aynurin/nourik/README.md

# NourK

ToDo:

 - [ ] Find a chip.
 - [#1](/../../issues/1) Create a layout
 - [#2](/../../issues/2) Find an existing PCB
