aynurin/nourik/pcb/core/Nour-Core.kicad_pcb

## KiCad design pcb/core/Nour-Core.kicad_pcb (2022-09-10)

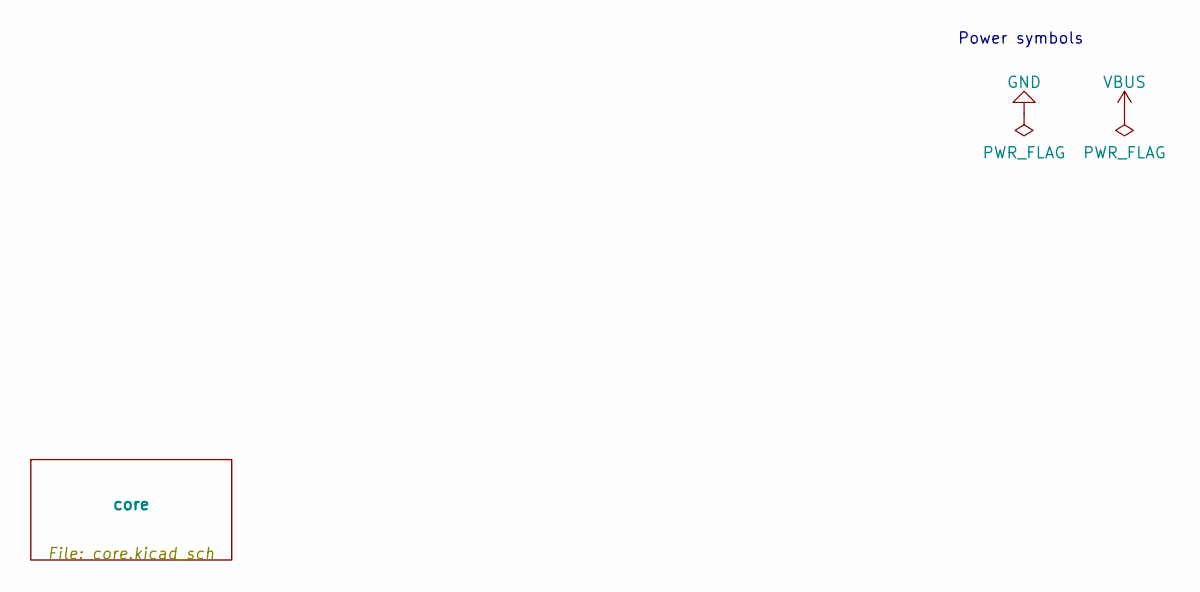
[picture p3: schematic Nour-Core.kicad_sch]

Notes on the sheet:
Power symbols

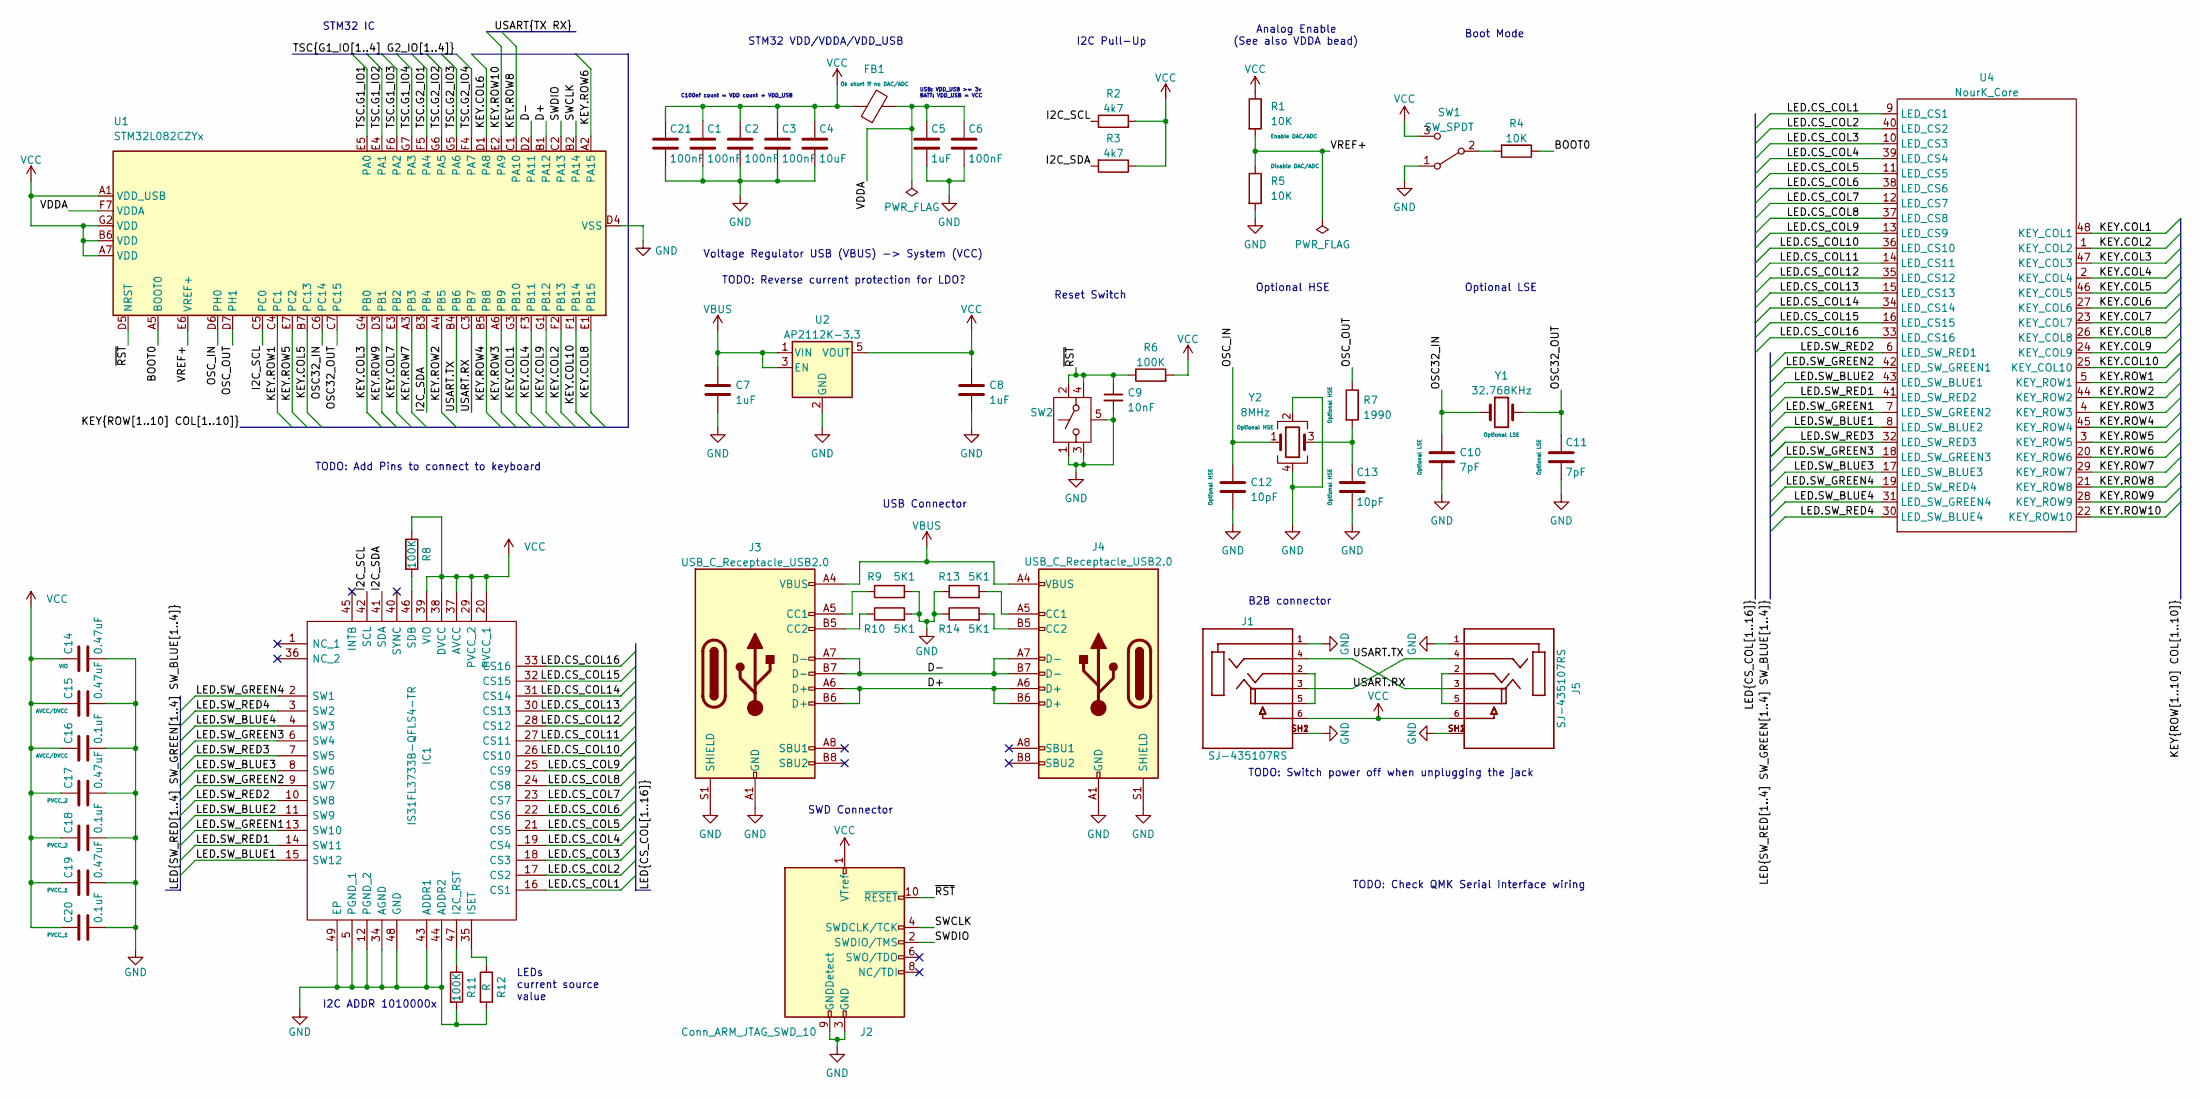
[picture p4: schematic core.kicad_sch]

Parts:
C1, C2, C3, C6, C21: 100nF; C_0805_2012Metric
C4: 10uF; C_0805_2012Metric
C5, C7, C8: 1uF; C_0805_2012Metric
C9: 10nF; C_0805_2012Metric
C10, C11: 7pF; C_0805_2012Metric
C12, C13: 10pF; C_0805_2012Metric
C14, C15, C17, C19: 0.47uF; C_0805_2012Metric
C16, C18, C20: 0.1uF; C_0805_2012Metric
FB1: FerriteBead; R_0805_2012Metric
IC1: IS31FL3733B-QFLS4-TR; QFN40P600X600X80-49N-D; Manufacturer_Part_Number IS31FL3733B-QFLS4-TR; Mouser Part Number 870-IS31FL3733BQFLS4
J1, J5: SJ-435107RS; CUI_SJ-435107RS
J2: Conn_ARM_JTAG_SWD_10; PinSocket_2x05_P1.27mm_Vertical
J3, J4: USB_C_Receptacle_USB2.0; GCT_USB4085-GF-A_REVA4
R1, R4, R5: 10K; R_0805_2012Metric
R2, R3: 4k7; R_0805_2012Metric
R6, R8, R11: 100K; R_0805_2012Metric
R7: 1990; R_0805_2012Metric
R9, R10, R13, R14: 5K1; R_0805_2012Metric
R12: R; R_0805_2012Metric
SW1: SW_SPDT; CSS-1211TB
SW2: SW_SPST_G; EVQP9102W; PartNo EVQ-P9102W
U1: STM32L082CZYx; ST_WLCSP-49_Die447
U2: AP2112K-3.3; SOT-23-5
U4: NourK_Core; Nour_Core
Y1: 32.768KHz; ECS327712TR; PartNo ECS-.327-7-12-TR
Y2: 8MHz; ECS801830BAGNTR; PartNo ECS-80-10-30B-CWN-TR

Connections:
/core/BOOT0: R4.1, U1.A5 (BOOT0)
/core/D+: J3.A6 (D+), J3.B6 (D+), J4.A6 (D+), J4.B6 (D+), U1.B1 (PA12)
/core/D-: J3.A7 (D-), J3.B7 (D-), J4.A7 (D-), J4.B7 (D-), U1.D2 (PA11)
/core/I2C_SCL: IC1.42 (SCL), R2.1, U1.C5 (PC0)
/core/I2C_SDA: IC1.41 (SDA), R3.2, U1.B3 (PB4)
/core/KEY.COL1: U1.G3 (PB10), U4.48 (KEY_COL1)
/core/KEY.COL2: U1.F2 (PB13), U4.1 (KEY_COL2)
/core/KEY.COL3: U1.G4 (PB0), U4.47 (KEY_COL3)
/core/KEY.COL4: U1.F3 (PB11), U4.2 (KEY_COL4)
/core/KEY.COL5: U1.B7 (PC13), U4.46 (KEY_COL5)
/core/KEY.COL6: U1.D1 (PA8), U4.27 (KEY_COL6)
/core/KEY.COL7: U1.E3 (PB2), U4.23 (KEY_COL7)
/core/KEY.COL8: U1.E1 (PB15), U4.26 (KEY_COL8)
/core/KEY.COL9: U1.G1 (PB12), U4.24 (KEY_COL9)
/core/KEY.COL10: U1.F1 (PB14), U4.25 (KEY_COL10)
/core/KEY.ROW1: U1.C4 (PC1), U4.5 (KEY_ROW1)
/core/KEY.ROW2: U1.A4 (PB5), U4.44 (KEY_ROW2)
/core/KEY.ROW3: U1.A6 (PB9), U4.4 (KEY_ROW3)
/core/KEY.ROW4: U1.B5 (PB8), U4.45 (KEY_ROW4)
/core/KEY.ROW5: U1.E7 (PC2), U4.3 (KEY_ROW5)
/core/KEY.ROW6: U1.A2 (PA15), U4.20 (KEY_ROW6)
/core/KEY.ROW7: U1.A3 (PB3), U4.29 (KEY_ROW7)
/core/KEY.ROW8: U1.C1 (PA10), U4.21 (KEY_ROW8)
/core/KEY.ROW9: U1.D3 (PB1), U4.28 (KEY_ROW9)
/core/KEY.ROW10: U1.E2 (PA9), U4.22 (KEY_ROW10)
/core/LED.CS_COL1: IC1.16 (CS1), U4.9 (LED_CS1)
/core/LED.CS_COL2: IC1.17 (CS2), U4.40 (LED_CS2)
/core/LED.CS_COL3: IC1.18 (CS3), U4.10 (LED_CS3)
/core/LED.CS_COL4: IC1.19 (CS4), U4.39 (LED_CS4)
/core/LED.CS_COL5: IC1.21 (CS5), U4.11 (LED_CS5)
/core/LED.CS_COL6: IC1.22 (CS6), U4.38 (LED_CS6)
/core/LED.CS_COL7: IC1.23 (CS7), U4.12 (LED_CS7)
/core/LED.CS_COL8: IC1.24 (CS8), U4.37 (LED_CS8)
/core/LED.CS_COL9: IC1.25 (CS9), U4.13 (LED_CS9)
/core/LED.CS_COL10: IC1.26 (CS10), U4.36 (LED_CS10)
/core/LED.CS_COL11: IC1.27 (CS11), U4.14 (LED_CS11)
/core/LED.CS_COL12: IC1.28 (CS12), U4.35 (LED_CS12)
/core/LED.CS_COL13: IC1.30 (CS13), U4.15 (LED_CS13)
/core/LED.CS_COL14: IC1.31 (CS14), U4.34 (LED_CS14)
/core/LED.CS_COL15: IC1.32 (CS15), U4.16 (LED_CS15)
/core/LED.CS_COL16: IC1.33 (CS16), U4.33 (LED_CS16)
/core/LED.SW_BLUE1: IC1.15 (SW12), U4.8 (LED_SW_BLUE2)
/core/LED.SW_BLUE2: IC1.11 (SW9), U4.43 (LED_SW_BLUE1)
/core/LED.SW_BLUE3: IC1.8 (SW6), U4.17 (LED_SW_BLUE3)
/core/LED.SW_BLUE4: IC1.4 (SW3), U4.31 (LED_SW_GREEN4)
/core/LED.SW_GREEN1: IC1.13 (SW10), U4.7 (LED_SW_GREEN2)
/core/LED.SW_GREEN2: IC1.9 (SW7), U4.42 (LED_SW_GREEN1)
/core/LED.SW_GREEN3: IC1.6 (SW4), U4.18 (LED_SW_GREEN3)
/core/LED.SW_GREEN4: IC1.2 (SW1), U4.19 (LED_SW_RED4)
/core/LED.SW_RED1: IC1.14 (SW11), U4.41 (LED_SW_RED2)
/core/LED.SW_RED2: IC1.10 (SW8), U4.6 (LED_SW_RED1)
/core/LED.SW_RED3: IC1.7 (SW5), U4.32 (LED_SW_RED3)
/core/LED.SW_RED4: IC1.3 (SW2), U4.30 (LED_SW_BLUE4)
/core/OSC32_IN: C10.1, U1.C6 (PC14), Y1.1
/core/OSC32_OUT: C11.1, U1.C7 (PC15), Y1.2
/core/OSC_IN: C12.1, U1.D6 (PH0), Y2.1
/core/OSC_OUT: R7.1, U1.D7 (PH1)
/core/SWCLK: J2.4 (SWDCLK/TCK), U1.B2 (PA14)
/core/SWDIO: J2.2 (SWDIO/TMS), U1.C2 (PA13)
/core/TSC.G1_IO1: U1.E5 (PA0)
/core/TSC.G1_IO2: U1.E4 (PA1)
/core/TSC.G1_IO3: U1.F6 (PA2)
/core/TSC.G1_IO4: U1.G7 (PA3)
/core/TSC.G2_IO1: U1.F5 (PA4)
/core/TSC.G2_IO2: U1.G6 (PA5)
/core/TSC.G2_IO3: U1.G5 (PA6)
/core/TSC.G2_IO4: U1.F4 (PA7)
/core/USART.RX: J1.3, J5.4, U1.C3 (PB7)
/core/USART.TX: J1.4, J5.3, U1.B4 (PB6)
/core/VDDA: C5.1, C6.1, FB1.2, U1.F7 (VDDA)
/core/VREF+: R1.2, R5.1, U1.E6 (VREF+)
/core/~RST: C9.1, J2.10 (~RESET), R6.1, SW2.2 (B), SW2.4 (B), U1.D5 (NRST)
GND: C1.2, C2.2, C3.2, C4.2, C5.2, C6.2, C7.2, C8.2, C9.2, C10.2, C11.2, C12.2, C13.2, C14.2, C15.2, C16.2, C17.2, C18.2, C19.2, C20.2, C21.2, IC1.5 (PGND_1), IC1.12 (PGND_2), IC1.34 (AGND), IC1.43 (ADDR1), IC1.44 (ADDR2), IC1.48 (GND), IC1.49 (EP), J1.1, J1.SH1, J1.SH2, J2.3 (GND), J2.5 (GND), J2.9 (GNDDetect), J3.A1 (GND), J3.A12 (GND), J3.B1 (GND), J3.B12 (GND), J3.S1 (SHIELD), J4.A1 (GND), J4.A12 (GND), J4.B1 (GND), J4.B12 (GND), J4.S1 (SHIELD), J5.1, J5.SH1, J5.SH2, R5.2, R9.2, R10.2, R11.2, R12.2, R13.1, R14.1, SW1.1 (A), SW2.1 (A), SW2.3 (A), SW2.5 (G), U1.D4 (VSS), U2.2 (GND), Y2.2, Y2.4
unnamed: C13.1, R7.2, Y2.3
unnamed: IC1.35 (ISET), R12.1
unnamed: IC1.46 (SDB), R8.2
unnamed: IC1.47 (I2C_RST), R11.1
unnamed: J1.2, J1.5
unnamed: J3.A5 (CC1), R9.1
unnamed: J3.B5 (CC2), R10.1
unnamed: J4.A5 (CC1), R13.2
unnamed: J4.B5 (CC2), R14.2
unnamed: J5.2, J5.5
unnamed: R4.2, SW1.2 (B)
VBUS: C7.1, J3.A4 (VBUS), J3.A9 (VBUS), J3.B4 (VBUS), J3.B9 (VBUS), J4.A4 (VBUS), J4.A9 (VBUS), J4.B4 (VBUS), J4.B9 (VBUS), U2.1 (VIN), U2.3 (EN)
VCC: C1.1, C2.1, C3.1, C4.1, C8.1, C14.1, C15.1, C16.1, C17.1, C18.1, C19.1, C20.1, C21.1, FB1.1, IC1.20 (PVCC_1), IC1.29 (PVCC_2), IC1.37 (AVCC), IC1.38 (DVCC), IC1.39 (VIO), J1.6, J2.1 (VTref), J5.6, R1.1, R2.2, R3.1, R6.2, R8.1, SW1.3 (C), U1.A1 (VDD_USB), U1.A7 (VDD), U1.B6 (VDD), U1.G2 (VDD), U2.5 (VOUT)

Notes on the sheet:
Boot Mode
Voltage Regulator USB (VBUS) -> System (VCC)
C100nf count = VDD count + VDD_USB
STM32 VDD/VDDA/VDD_USB
I2C Pull-Up
Optional LSE
LEDs current source value
TODO: Switch power off when unplugging the jack
I2C ADDR 1010000x
Optional HSE
Reset Switch
STM32 IC
TODO: Check QMK Serial Interface wiring
Analog Enable (See also VDDA bead)
SWD Connector
TODO: Reverse current protection for LDO?
USB Connector
TODO: Add Pins to connect to keyboard
B2B connector
USB: VDD_USB >= 3v BATT: VDD_USB = VCC

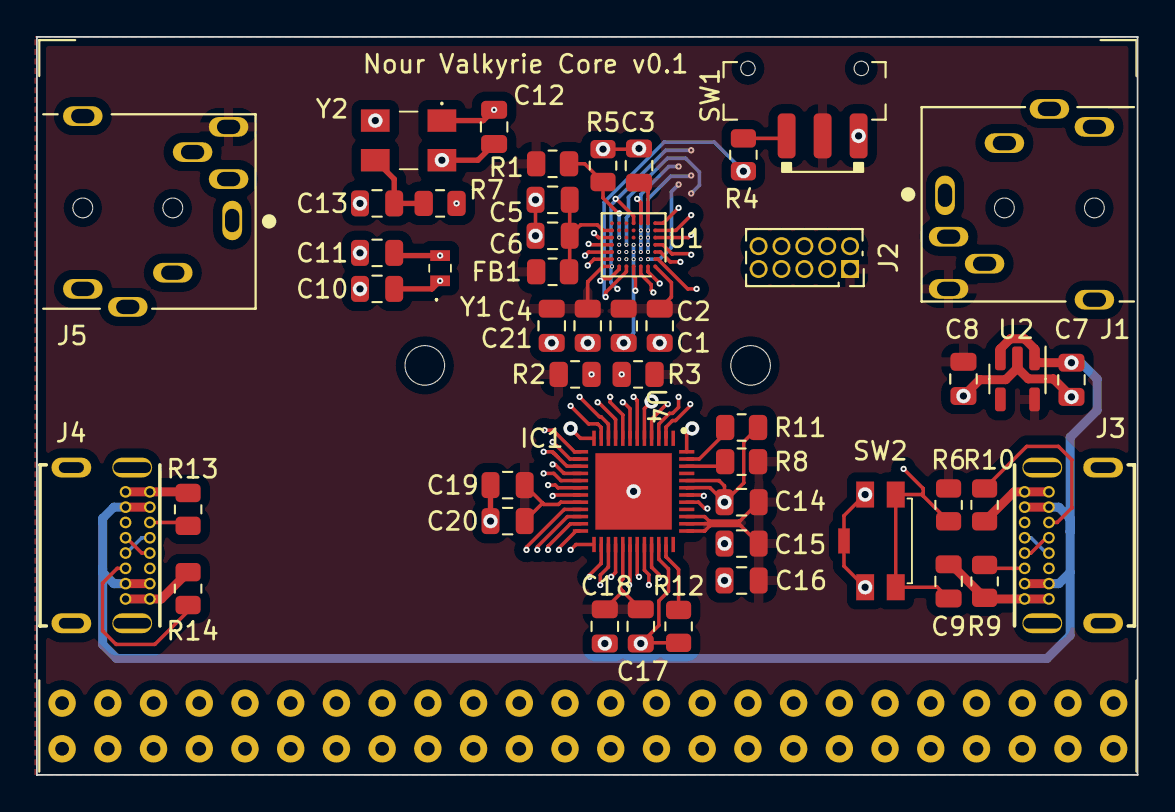
[picture p5: board Nour-Core.kicad_pcb from above]

Board: 4 copper layers, 61.2 x 41.0 mm, 49 parts (0 on the bottom side), 78 nets.
