aynurin/nourik/pcb/core-bb/core-bb.kicad_pcb

## KiCad design pcb/core-bb/core-bb.kicad_pcb (2022-09-10)

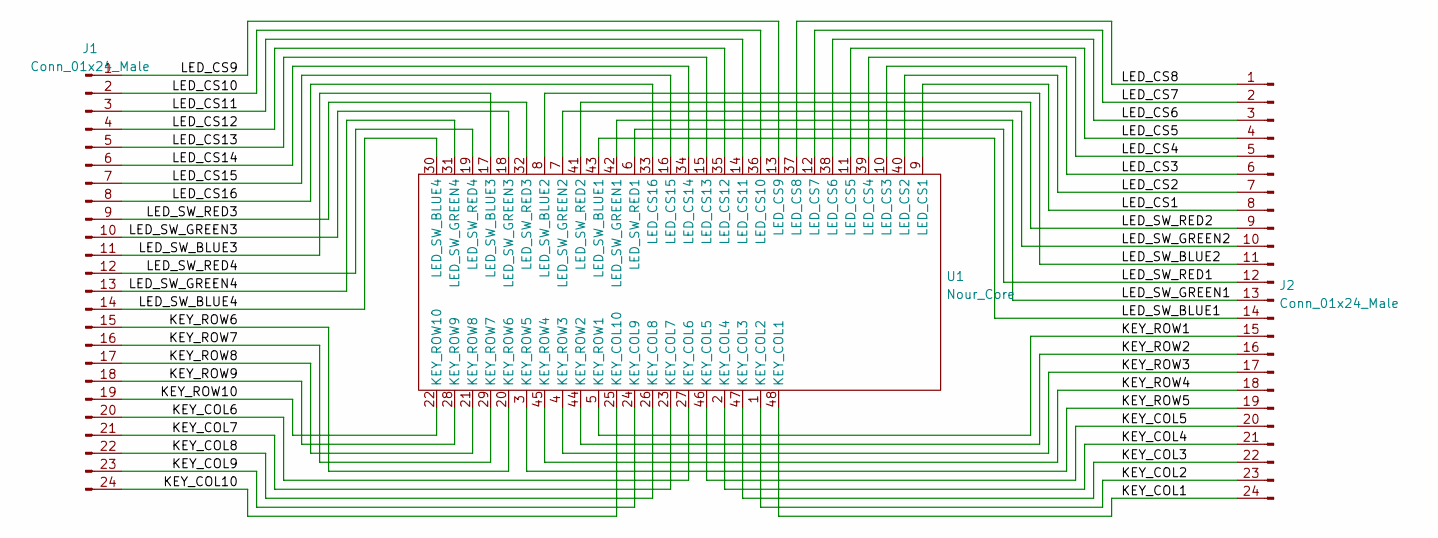
[picture p6: schematic core-bb.kicad_sch, Core Breadboard Connector]

Parts:
J1, J2: Conn_01x24_Male; PinHeader_1x24_P2.54mm_Vertical
U1: Nour_Core

Connections:
/KEY_COL1: J2.24, U1.48 (KEY_COL1)
/KEY_COL2: J2.23, U1.1 (KEY_COL2)
/KEY_COL3: J2.22, U1.47 (KEY_COL3)
/KEY_COL4: J2.21, U1.2 (KEY_COL4)
/KEY_COL5: J2.20, U1.46 (KEY_COL5)
/KEY_COL6: J1.20, U1.27 (KEY_COL6)
/KEY_COL7: J1.21, U1.23 (KEY_COL7)
/KEY_COL8: J1.22, U1.26 (KEY_COL8)
/KEY_COL9: J1.23, U1.24 (KEY_COL9)
/KEY_COL10: J1.24, U1.25 (KEY_COL10)
/KEY_ROW1: J2.15, U1.5 (KEY_ROW1)
/KEY_ROW2: J2.16, U1.44 (KEY_ROW2)
/KEY_ROW3: J2.17, U1.4 (KEY_ROW3)
/KEY_ROW4: J2.18, U1.45 (KEY_ROW4)
/KEY_ROW5: J2.19, U1.3 (KEY_ROW5)
/KEY_ROW6: J1.15, U1.20 (KEY_ROW6)
/KEY_ROW7: J1.16, U1.29 (KEY_ROW7)
/KEY_ROW8: J1.17, U1.21 (KEY_ROW8)
/KEY_ROW9: J1.18, U1.28 (KEY_ROW9)
/KEY_ROW10: J1.19, U1.22 (KEY_ROW10)
/LED_CS1: J2.8, U1.9 (LED_CS1)
/LED_CS2: J2.7, U1.40 (LED_CS2)
/LED_CS3: J2.6, U1.10 (LED_CS3)
/LED_CS4: J2.5, U1.39 (LED_CS4)
/LED_CS5: J2.4, U1.11 (LED_CS5)
/LED_CS6: J2.3, U1.38 (LED_CS6)
/LED_CS7: J2.2, U1.12 (LED_CS7)
/LED_CS8: J2.1, U1.37 (LED_CS8)
/LED_CS9: J1.1, U1.13 (LED_CS9)
/LED_CS10: J1.2, U1.36 (LED_CS10)
/LED_CS11: J1.3, U1.14 (LED_CS11)
/LED_CS12: J1.4, U1.35 (LED_CS12)
/LED_CS13: J1.5, U1.15 (LED_CS13)
/LED_CS14: J1.6, U1.34 (LED_CS14)
/LED_CS15: J1.7, U1.16 (LED_CS15)
/LED_CS16: J1.8, U1.33 (LED_CS16)
/LED_SW_BLUE1: J2.14, U1.43 (LED_SW_BLUE1)
/LED_SW_BLUE2: J2.11, U1.8 (LED_SW_BLUE2)
/LED_SW_BLUE3: J1.11, U1.17 (LED_SW_BLUE3)
/LED_SW_BLUE4: J1.14, U1.30 (LED_SW_BLUE4)
/LED_SW_GREEN1: J2.13, U1.42 (LED_SW_GREEN1)
/LED_SW_GREEN2: J2.10, U1.7 (LED_SW_GREEN2)
/LED_SW_GREEN3: J1.10, U1.18 (LED_SW_GREEN3)
/LED_SW_GREEN4: J1.13, U1.31 (LED_SW_GREEN4)
/LED_SW_RED1: J2.12, U1.6 (LED_SW_RED1)
/LED_SW_RED2: J2.9, U1.41 (LED_SW_RED2)
/LED_SW_RED3: J1.9, U1.32 (LED_SW_RED3)
/LED_SW_RED4: J1.12, U1.19 (LED_SW_RED4)

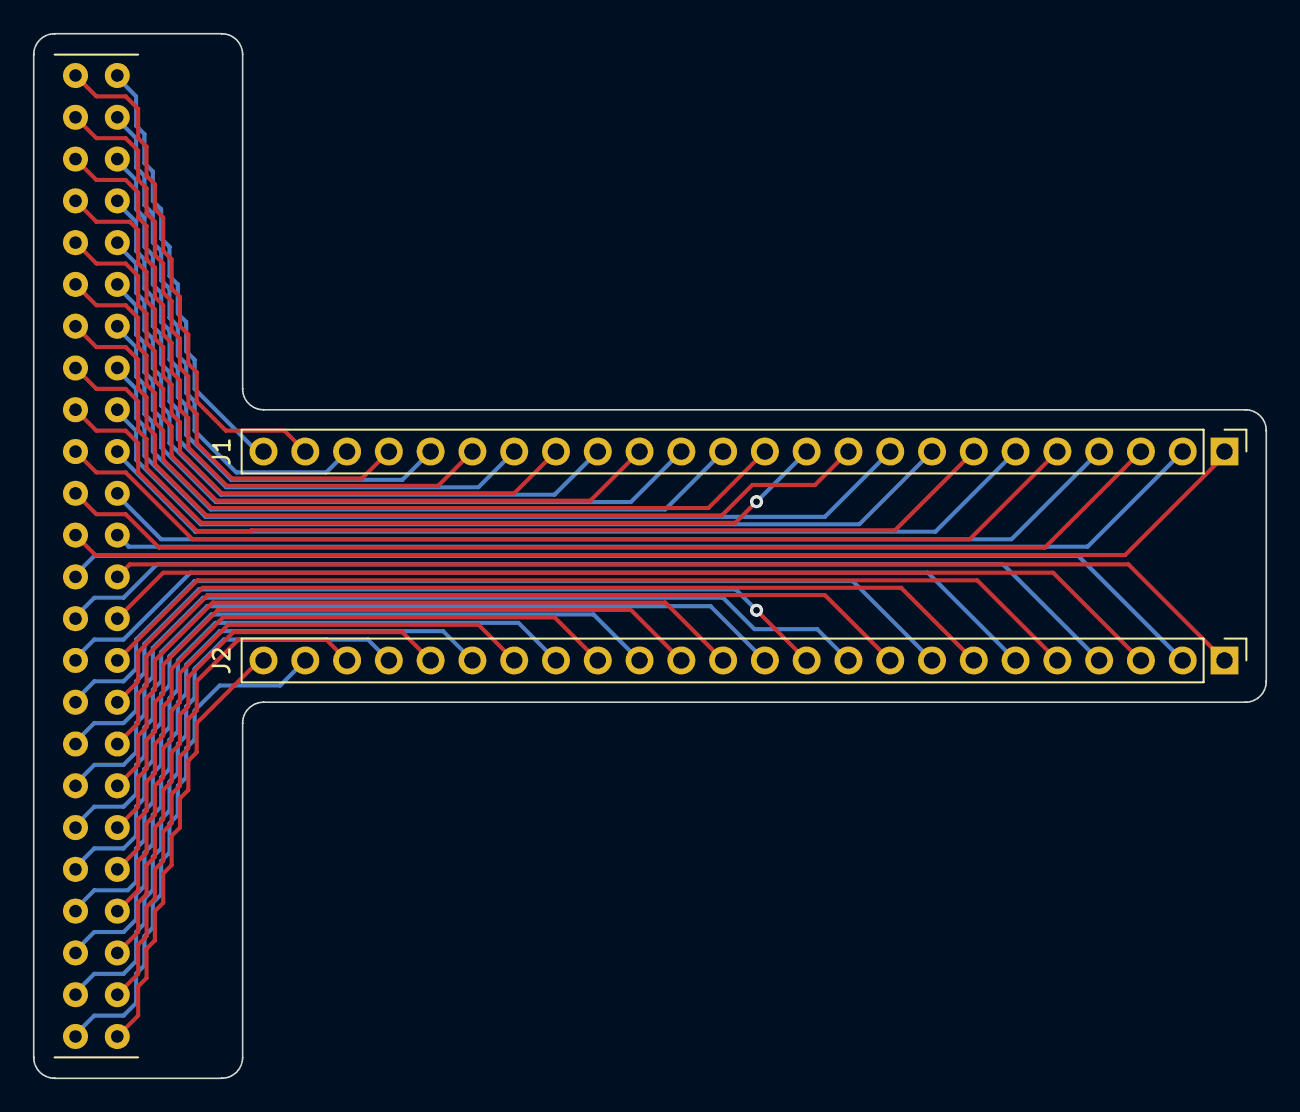
[picture p7: board core-bb.kicad_pcb from above]

Board: 2 copper layers, 74.9 x 63.5 mm, 3 parts (0 on the bottom side), 48 nets.
