aynurin/nourik/pcb/valkyrie/Nour-Valkyrie.kicad_pcb

## KiCad design pcb/valkyrie/Nour-Valkyrie.kicad_pcb (2022-09-04)

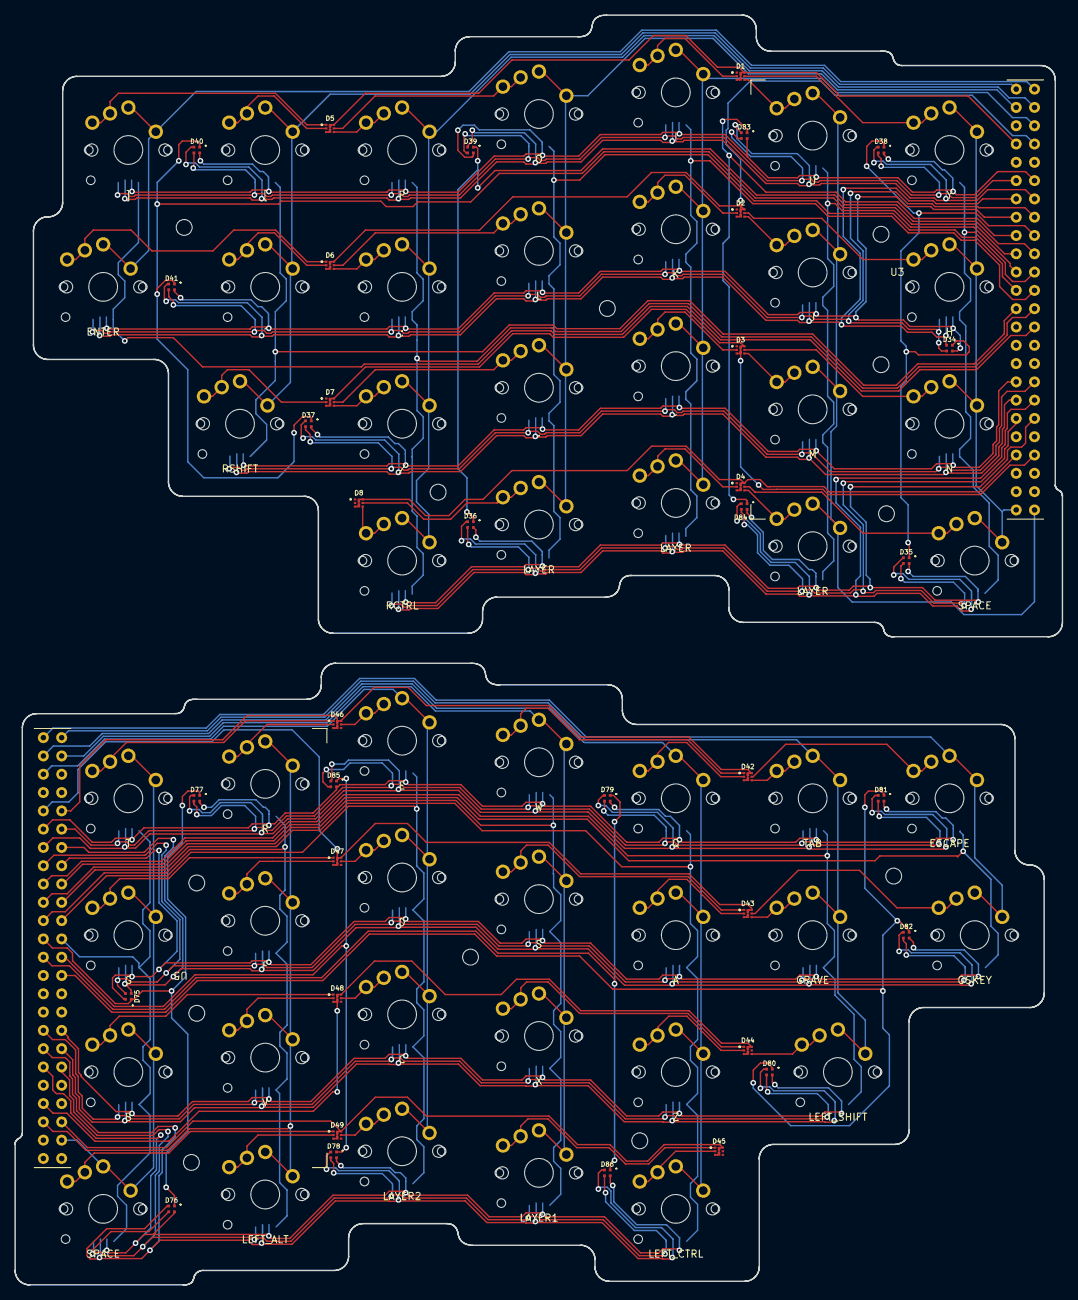
[picture p8: board Nour-Valkyrie.kicad_pcb from above]

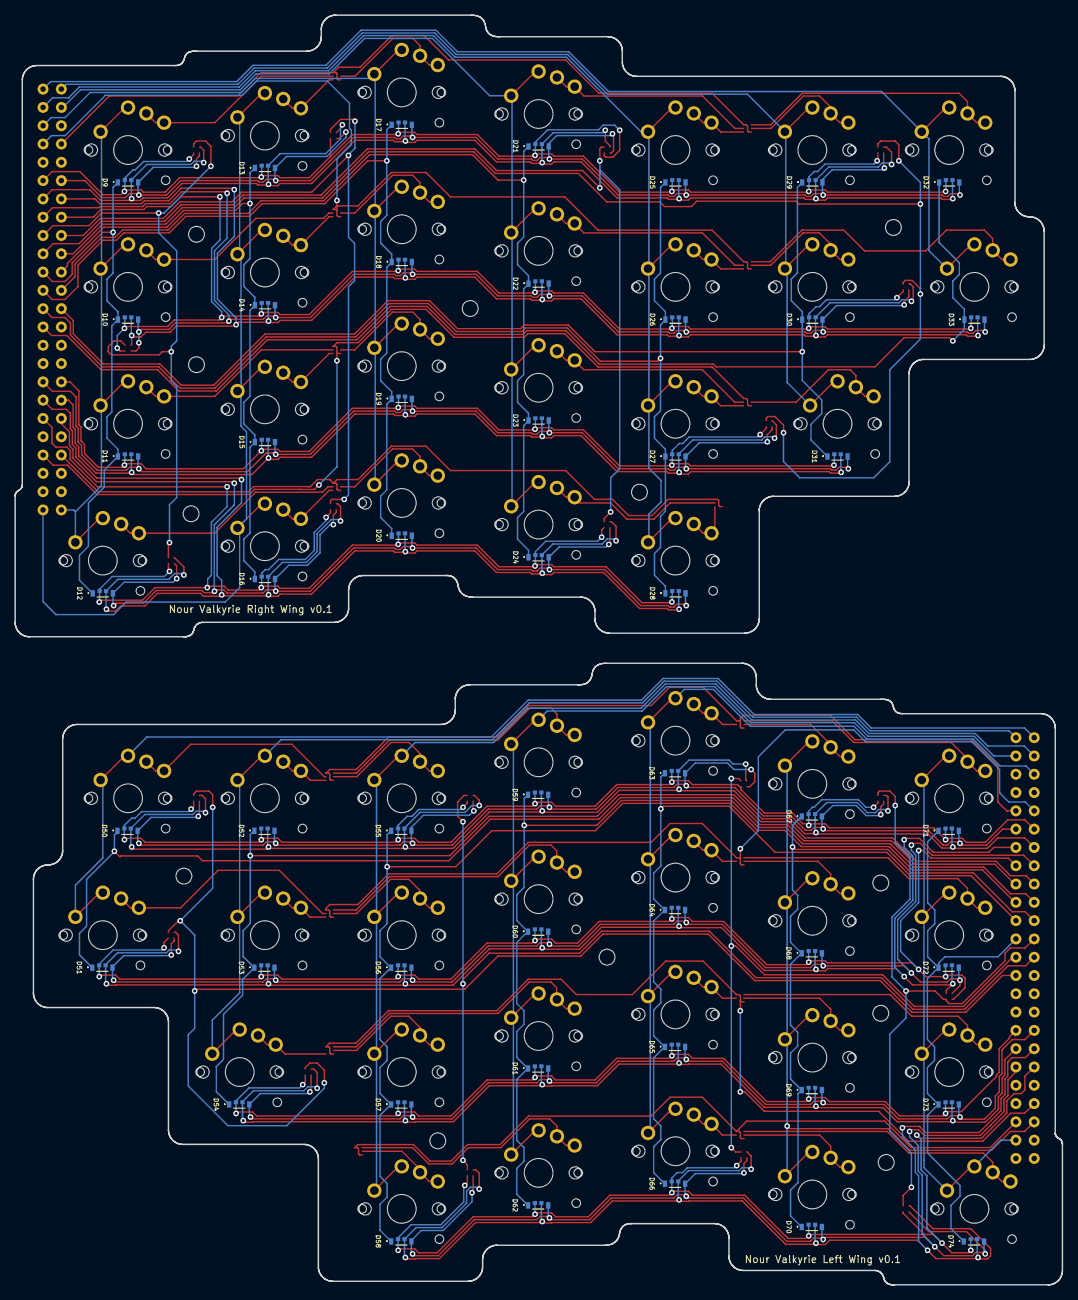
[picture p9: board Nour-Valkyrie.kicad_pcb from below]

Board: 2 copper layers, 145.4 x 176.3 mm, 138 parts (50 on the bottom side), 118 nets.

Parts:
D1, D2, D3, D4, D5, D6, D7, D8, D42, D43, D44, D45, D46, D47, D48, D49: BAV70SRAZ; DIO_BAV70SRAZ
D9: LED_Y; 155124M173200
D10: LED_H; 155124M173200
D11: LED_N; 155124M173200
D12, D74: LED_SPACE; 155124M173200
D13: LED_U; 155124M173200
D14: LED_J; 155124M173200
D15: LED_M; 155124M173200
D16, D62: LED_LAYER1; 155124M173200
D17: LED_I; 155124M173200
D18: LED_K; 155124M173200
D19: LED_COMMA; 155124M173200
D20, D66: LED_LAYER2; 155124M173200
D21: LED_O; 155124M173200
D22: LED_L; 155124M173200
D23: LED_DOT; 155124M173200
D24: LED_LAYER3; 155124M173200
D25: LED_P; 155124M173200
D26: LED_SEMICOLON; 155124M173200
D27: LED_FSLASH; 155124M173200
D28: LED_RCTRL; 155124M173200
D29: LED_LBRACE; 155124M173200
D30: LED_APOSTROPHE; 155124M173200
D31: LED_RSHIFT; 155124M173200
D32: LED_RBRACE; 155124M173200
D33: LED_ENTER; 155124M173200
D34: LED_UG_3_1; LTRBR37G4R4S012502R18
D35: LED_UG_3_2; LTRBR37G4R4S012502R18
D36, D84: LED_UG_3_3; LTRBR37G4R4S012502R18
D37: LED_UG_3_4; LTRBR37G4R4S012502R18
D38: LED_UG_4_1; LTRBR37G4R4S012502R18
D39, D83: LED_UG_4_2; LTRBR37G4R4S012502R18
D40: LED_UG_4_3; LTRBR37G4R4S012502R18
D41: LED_UG_4_4; LTRBR37G4R4S012502R18
D50: LED_ESCAPE; 155124M173200
D51: LED_OSKEY; 155124M173200
D52: LED_TAB; 155124M173200
D53: LED_GRAVE; 155124M173200
D54: LED_LSHIFT; 155124M173200
D55: LED_Q; 155124M173200
D56: LED_A; 155124M173200
D57: LED_Z; 155124M173200
D58: LED_LCTRL; 155124M173200
D59: LED_W; 155124M173200
D60: LED_S; 155124M173200
D61: LED_X; 155124M173200
D63: LED_E; 155124M173200
D64: LED_D; 155124M173200
D65: LED_C; 155124M173200
D67: LED_R; 155124M173200
D68: LED_F; 155124M173200
D69: LED_V; 155124M173200
D70: LED_LALT; 155124M173200
D71: LED_T; 155124M173200
D72: LED_G; 155124M173200
D73: LED_B; 155124M173200
D75: LED_UG_2_1; LTRBR37G4R4S012502R18
D76: LED_UG_2_2; LTRBR37G4R4S012502R18
D77: LED_UG_1_1; LTRBR37G4R4S012502R18
D78, D86: LED_UG_2_3; LTRBR37G4R4S012502R18
D79, D85: LED_UG_1_2; LTRBR37G4R4S012502R18
D80: LED_UG_2_4; LTRBR37G4R4S012502R18
D81: LED_UG_1_3; LTRBR37G4R4S012502R18
D82: LED_UG_1_4; LTRBR37G4R4S012502R18
SW3: Y; MX_Choc_1U
SW4: H; MX_Choc_1U
SW5: N; MX_Choc_1U
SW6, SW54: SPACE; MX_Choc_1U
SW7: U; MX_Choc_1U
SW8: J; MX_Choc_1U
SW9: M; MX_Choc_1U
SW10, SW14, SW18: LAYER; MX_Choc_1U
SW11: I; MX_Choc_1U
SW12: K; MX_Choc_1U
SW13: ,; MX_Choc_1U
SW15: O; MX_Choc_1U
SW16: L; MX_Choc_1U
SW17: .; MX_Choc_1U
SW19: P; MX_Choc_1U
SW20: ;; MX_Choc_1U
SW21: /; MX_Choc_1U
SW22: RCTRL; MX_Choc_1U
SW23: [; MX_Choc_1U
SW24: '; MX_Choc_1U
SW25: RSHIFT; MX_Choc_1U
SW26: ]; MX_Choc_1U
SW27: ENTER; MX_Choc_1U
SW30: ESCAPE; MX_Choc_1U
SW31: OSKEY; MX_Choc_1U
SW32: TAB; MX_Choc_1U
SW33: GRAVE; MX_Choc_1U
SW34: LEFT_SHIFT; MX_Choc_1U
SW35: Q; MX_Choc_1U
SW36: A; MX_Choc_1U
SW37: Z; MX_Choc_1U
SW38: LEFT_CTRL; MX_Choc_1U
SW39: W; MX_Choc_1U
SW40: S; MX_Choc_1U
SW41: X; MX_Choc_1U
SW42: LAYER1; MX_Choc_1U
SW43: E; MX_Choc_1U
SW44: D; MX_Choc_1U
SW45: C; MX_Choc_1U
SW46: LAYER2; MX_Choc_1U
SW47: R; MX_Choc_1U
SW48: F; MX_Choc_1U
SW49: V; MX_Choc_1U
SW50: LEFT_ALT; MX_Choc_1U
SW51: T; MX_Choc_1U
SW52: G; MX_Choc_1U
SW53: B; MX_Choc_1U
U3, U5: NourK_Core; Nour_Core

Connections:
/lhs/LHS Keys/KEY.COL1: SW30.2 (B), SW31.2 (B), U5.48 (KEY_COL1)
/lhs/LHS Keys/KEY.COL2: SW32.2 (B), SW33.2 (B), SW34.2 (B), U5.1 (KEY_COL2)
/lhs/LHS Keys/KEY.COL3: SW35.2 (B), SW36.2 (B), SW37.2 (B), SW38.2 (B), U5.47 (KEY_COL3)
/lhs/LHS Keys/KEY.COL4: SW39.2 (B), SW40.2 (B), SW41.2 (B), SW42.2 (B), U5.2 (KEY_COL4)
/lhs/LHS Keys/KEY.COL5: SW43.2 (B), SW44.2 (B), SW45.2 (B), SW46.2 (B), U5.46 (KEY_COL5)
/lhs/LHS Keys/KEY.COL6: SW47.2 (B), SW48.2 (B), SW49.2 (B), SW50.2 (B), U5.27 (KEY_COL6)
/lhs/LHS Keys/KEY.COL7: SW51.2 (B), SW52.2 (B), SW53.2 (B), SW54.2 (B), U5.23 (KEY_COL7)
/lhs/LHS Keys/KEY.ROW1: D42.3, D42.6, D42.7, D42.8, D46.3, D46.6, D46.7, D46.8, U5.5 (KEY_ROW1)
/lhs/LHS Keys/KEY.ROW2: D43.3, D43.6, D43.7, D43.8, D47.3, D47.6, D47.7, D47.8, U5.44 (KEY_ROW2)
/lhs/LHS Keys/KEY.ROW9: D44.3, D44.6, D44.7, D44.8, D48.3, D48.6, D48.7, D48.8, U5.28 (KEY_ROW9)
/lhs/LHS Keys/KEY.ROW10: D45.3, D45.6, D45.7, D45.8, D49.3, D49.6, D49.7, D49.8, U5.22 (KEY_ROW10)
/lhs/LHS LEDs/LED.CS_COL1: D50.1 (A), D51.1 (A), U5.9 (LED_CS1)
/lhs/LHS LEDs/LED.CS_COL2: D52.1 (A), D53.1 (A), D54.1 (A), U5.40 (LED_CS2)
/lhs/LHS LEDs/LED.CS_COL3: D55.1 (A), D56.1 (A), D57.1 (A), D58.1 (A), U5.10 (LED_CS3)
/lhs/LHS LEDs/LED.CS_COL4: D59.1 (A), D60.1 (A), D61.1 (A), D62.1 (A), U5.39 (LED_CS4)
/lhs/LHS LEDs/LED.CS_COL5: D63.1 (A), D64.1 (A), D65.1 (A), D66.1 (A), U5.11 (LED_CS5)
/lhs/LHS LEDs/LED.CS_COL6: D67.1 (A), D68.1 (A), D69.1 (A), D70.1 (A), U5.38 (LED_CS6)
/lhs/LHS LEDs/LED.CS_COL7: D71.1 (A), D72.1 (A), D73.1 (A), D74.1 (A), U5.12 (LED_CS7)
/lhs/LHS LEDs/LED.CS_COL8: D75.1 (A), D76.1 (A), D77.1 (A), U5.37 (LED_CS8)
/lhs/LHS LEDs/LED.CS_COL9: D78.1 (A), D85.1 (A), U5.13 (LED_CS9)
/lhs/LHS LEDs/LED.CS_COL10: D79.1 (A), D86.1 (A), U5.36 (LED_CS10)
/lhs/LHS LEDs/LED.CS_COL11: D80.1 (A), D81.1 (A), D82.1 (A), U5.14 (LED_CS11)
/lhs/LHS LEDs/LED.SW_BLUE1: D50.2 (BK), D52.2 (BK), D55.2 (BK), D59.2 (BK), D63.2 (BK), D67.2 (BK), D71.2 (BK), D77.3 (BK), D79.3 (BK), D81.3 (BK), D85.3 (BK), U5.43 (LED_SW_BLUE1)
/lhs/LHS LEDs/LED.SW_BLUE2: D51.2 (BK), D53.2 (BK), D56.2 (BK), D60.2 (BK), D64.2 (BK), D68.2 (BK), D72.2 (BK), D75.3 (BK), D82.3 (BK), U5.8 (LED_SW_BLUE2)
/lhs/LHS LEDs/LED.SW_BLUE3: D54.2 (BK), D57.2 (BK), D61.2 (BK), D65.2 (BK), D69.2 (BK), D73.2 (BK), D80.3 (BK), U5.17 (LED_SW_BLUE3)
/lhs/LHS LEDs/LED.SW_BLUE4: D58.2 (BK), D62.2 (BK), D66.2 (BK), D70.2 (BK), D74.2 (BK), D76.3 (BK), D78.3 (BK), D86.3 (BK), U5.30 (LED_SW_BLUE4)
/lhs/LHS LEDs/LED.SW_GREEN1: D50.3 (GK), D52.3 (GK), D55.3 (GK), D59.3 (GK), D63.3 (GK), D67.3 (GK), D71.3 (GK), D77.4 (GK), D79.4 (GK), D81.4 (GK), D85.4 (GK), U5.42 (LED_SW_GREEN1)
/lhs/LHS LEDs/LED.SW_GREEN2: D51.3 (GK), D53.3 (GK), D56.3 (GK), D60.3 (GK), D64.3 (GK), D68.3 (GK), D72.3 (GK), D75.4 (GK), D82.4 (GK), U5.7 (LED_SW_GREEN2)
/lhs/LHS LEDs/LED.SW_GREEN3: D54.3 (GK), D57.3 (GK), D61.3 (GK), D65.3 (GK), D69.3 (GK), D73.3 (GK), D80.4 (GK), U5.18 (LED_SW_GREEN3)
/lhs/LHS LEDs/LED.SW_GREEN4: D58.3 (GK), D62.3 (GK), D66.3 (GK), D70.3 (GK), D74.3 (GK), D76.4 (GK), D78.4 (GK), D86.4 (GK), U5.31 (LED_SW_GREEN4)
/lhs/LHS LEDs/LED.SW_RED1: D50.4 (RK), D52.4 (RK), D55.4 (RK), D59.4 (RK), D63.4 (RK), D67.4 (RK), D71.4 (RK), D77.2 (RK), D79.2 (RK), D81.2 (RK), D85.2 (RK), U5.6 (LED_SW_RED1)
/lhs/LHS LEDs/LED.SW_RED2: D51.4 (RK), D53.4 (RK), D56.4 (RK), D60.4 (RK), D64.4 (RK), D68.4 (RK), D72.4 (RK), D75.2 (RK), D82.2 (RK), U5.41 (LED_SW_RED2)
/lhs/LHS LEDs/LED.SW_RED3: D54.4 (RK), D57.4 (RK), D61.4 (RK), D65.4 (RK), D69.4 (RK), D73.4 (RK), D80.2 (RK), U5.32 (LED_SW_RED3)
/lhs/LHS LEDs/LED.SW_RED4: D58.4 (RK), D62.4 (RK), D66.4 (RK), D70.4 (RK), D74.4 (RK), D76.2 (RK), D78.2 (RK), D86.2 (RK), U5.19 (LED_SW_RED4)
/rhs/RHS Keys/KEY.COL1: SW7.2 (B), SW8.2 (B), SW9.2 (B), SW10.2 (B), U3.48 (KEY_COL1)
/rhs/RHS Keys/KEY.COL2: SW3.2 (B), SW4.2 (B), SW5.2 (B), SW6.2 (B), U3.1 (KEY_COL2)
/rhs/RHS Keys/KEY.COL6: SW11.2 (B), SW12.2 (B), SW13.2 (B), SW14.2 (B), U3.27 (KEY_COL6)
/rhs/RHS Keys/KEY.COL7: SW15.2 (B), SW16.2 (B), SW17.2 (B), SW18.2 (B), U3.23 (KEY_COL7)
/rhs/RHS Keys/KEY.COL8: SW19.2 (B), SW20.2 (B), SW21.2 (B), SW22.2 (B), U3.26 (KEY_COL8)
/rhs/RHS Keys/KEY.COL9: SW23.2 (B), SW24.2 (B), SW25.2 (B), U3.24 (KEY_COL9)
/rhs/RHS Keys/KEY.COL10: SW26.2 (B), SW27.2 (B), U3.25 (KEY_COL10)
/rhs/RHS Keys/KEY.ROW3: D4.3, D4.6, D4.7, D4.8, D8.3, D8.6, D8.7, D8.8, U3.4 (KEY_ROW3)
/rhs/RHS Keys/KEY.ROW4: D3.3, D3.6, D3.7, D3.8, D7.3, D7.6, D7.7, D7.8, U3.45 (KEY_ROW4)
/rhs/RHS Keys/KEY.ROW8: D1.3, D1.6, D1.7, D1.8, D5.3, D5.6, D5.7, D5.8, U3.21 (KEY_ROW8)
/rhs/RHS Keys/KEY.ROW9: D2.3, D2.6, D2.7, D2.8, D6.3, D6.6, D6.7, D6.8, U3.28 (KEY_ROW9)
/rhs/RHS LEDs/LED.CS_COL6: D32.1 (A), D33.1 (A), U3.38 (LED_CS6)
/rhs/RHS LEDs/LED.CS_COL7: D29.1 (A), D30.1 (A), D31.1 (A), U3.12 (LED_CS7)
/rhs/RHS LEDs/LED.CS_COL8: D25.1 (A), D26.1 (A), D27.1 (A), D28.1 (A), U3.37 (LED_CS8)
/rhs/RHS LEDs/LED.CS_COL9: D21.1 (A), D22.1 (A), D23.1 (A), D24.1 (A), U3.13 (LED_CS9)
/rhs/RHS LEDs/LED.CS_COL10: D17.1 (A), D18.1 (A), D19.1 (A), D20.1 (A), U3.36 (LED_CS10)
/rhs/RHS LEDs/LED.CS_COL11: D13.1 (A), D14.1 (A), D15.1 (A), D16.1 (A), U3.14 (LED_CS11)
/rhs/RHS LEDs/LED.CS_COL12: D9.1 (A), D10.1 (A), D11.1 (A), D12.1 (A), U3.35 (LED_CS12)
/rhs/RHS LEDs/LED.CS_COL13: D37.1 (A), D40.1 (A), D41.1 (A), U3.15 (LED_CS13)
/rhs/RHS LEDs/LED.CS_COL14: D36.1 (A), D39.1 (A), U3.34 (LED_CS14)
/rhs/RHS LEDs/LED.CS_COL15: D83.1 (A), D84.1 (A), U3.16 (LED_CS15)
/rhs/RHS LEDs/LED.CS_COL16: D34.1 (A), D35.1 (A), D38.1 (A), U3.33 (LED_CS16)
/rhs/RHS LEDs/LED.SW_BLUE1: D12.2 (BK), D16.2 (BK), D20.2 (BK), D24.2 (BK), D28.2 (BK), D35.3 (BK), D36.3 (BK), D84.3 (BK), U3.43 (LED_SW_BLUE1)
/rhs/RHS LEDs/LED.SW_BLUE2: D11.2 (BK), D15.2 (BK), D19.2 (BK), D23.2 (BK), D27.2 (BK), D31.2 (BK), D37.3 (BK), U3.8 (LED_SW_BLUE2)
/rhs/RHS LEDs/LED.SW_BLUE3: D10.2 (BK), D14.2 (BK), D18.2 (BK), D22.2 (BK), D26.2 (BK), D30.2 (BK), D33.2 (BK), D34.3 (BK), D41.3 (BK), U3.17 (LED_SW_BLUE3)
/rhs/RHS LEDs/LED.SW_BLUE4: D9.2 (BK), D13.2 (BK), D17.2 (BK), D21.2 (BK), D25.2 (BK), D29.2 (BK), D32.2 (BK), D38.3 (BK), D39.3 (BK), D40.3 (BK), D83.3 (BK), U3.30 (LED_SW_BLUE4)
/rhs/RHS LEDs/LED.SW_GREEN1: D12.3 (GK), D16.3 (GK), D20.3 (GK), D24.3 (GK), D28.3 (GK), D35.4 (GK), D36.4 (GK), D84.4 (GK), U3.42 (LED_SW_GREEN1)
/rhs/RHS LEDs/LED.SW_GREEN2: D11.3 (GK), D15.3 (GK), D19.3 (GK), D23.3 (GK), D27.3 (GK), D31.3 (GK), D37.4 (GK), U3.7 (LED_SW_GREEN2)
/rhs/RHS LEDs/LED.SW_GREEN3: D10.3 (GK), D14.3 (GK), D18.3 (GK), D22.3 (GK), D26.3 (GK), D30.3 (GK), D33.3 (GK), D34.4 (GK), D41.4 (GK), U3.18 (LED_SW_GREEN3)
/rhs/RHS LEDs/LED.SW_GREEN4: D9.3 (GK), D13.3 (GK), D17.3 (GK), D21.3 (GK), D25.3 (GK), D29.3 (GK), D32.3 (GK), D38.4 (GK), D39.4 (GK), D40.4 (GK), D83.4 (GK), U3.31 (LED_SW_GREEN4)
/rhs/RHS LEDs/LED.SW_RED1: D12.4 (RK), D16.4 (RK), D20.4 (RK), D24.4 (RK), D28.4 (RK), D35.2 (RK), D36.2 (RK), D84.2 (RK), U3.6 (LED_SW_RED1)
/rhs/RHS LEDs/LED.SW_RED2: D11.4 (RK), D15.4 (RK), D19.4 (RK), D23.4 (RK), D27.4 (RK), D31.4 (RK), D37.2 (RK), U3.41 (LED_SW_RED2)
/rhs/RHS LEDs/LED.SW_RED3: D10.4 (RK), D14.4 (RK), D18.4 (RK), D22.4 (RK), D26.4 (RK), D30.4 (RK), D33.4 (RK), D34.2 (RK), D41.2 (RK), U3.32 (LED_SW_RED3)
/rhs/RHS LEDs/LED.SW_RED4: D9.4 (RK), D13.4 (RK), D17.4 (RK), D21.4 (RK), D25.4 (RK), D29.4 (RK), D32.4 (RK), D38.2 (RK), D39.2 (RK), D40.2 (RK), D83.2 (RK), U3.19 (LED_SW_RED4)
unnamed: D1.2, SW11.1 (A)
unnamed: D1.4, SW7.1 (A)
unnamed: D1.5, SW3.1 (A)
unnamed: D2.2, SW12.1 (A)
unnamed: D2.4, SW8.1 (A)
unnamed: D2.5, SW4.1 (A)
unnamed: D3.2, SW13.1 (A)
unnamed: D3.4, SW9.1 (A)
unnamed: D3.5, SW5.1 (A)
unnamed: D4.2, SW14.1 (A)
unnamed: D4.4, SW10.1 (A)
unnamed: D4.5, SW6.1 (A)
unnamed: D5.1, SW26.1 (A)
unnamed: D5.2, SW23.1 (A)
unnamed: D5.4, SW19.1 (A)
unnamed: D5.5, SW15.1 (A)
unnamed: D6.1, SW27.1 (A)
unnamed: D6.2, SW24.1 (A)
unnamed: D6.4, SW20.1 (A)
unnamed: D6.5, SW16.1 (A)
unnamed: D7.2, SW25.1 (A)
unnamed: D7.4, SW21.1 (A)
unnamed: D7.5, SW17.1 (A)
unnamed: D8.4, SW22.1 (A)
unnamed: D8.5, SW18.1 (A)
unnamed: D42.1, SW39.1 (A)
unnamed: D42.2, SW35.1 (A)
unnamed: D42.4, SW32.1 (A)
unnamed: D42.5, SW30.1 (A)
unnamed: D43.1, SW40.1 (A)
unnamed: D43.2, SW36.1 (A)
unnamed: D43.4, SW33.1 (A)
unnamed: D43.5, SW31.1 (A)
unnamed: D44.1, SW41.1 (A)
unnamed: D44.2, SW37.1 (A)
unnamed: D44.4, SW34.1 (A)
unnamed: D45.1, SW42.1 (A)
unnamed: D45.2, SW38.1 (A)
unnamed: D46.1, SW51.1 (A)
unnamed: D46.2, SW47.1 (A)
unnamed: D46.5, SW43.1 (A)
unnamed: D47.1, SW52.1 (A)
unnamed: D47.2, SW48.1 (A)
unnamed: D47.5, SW44.1 (A)
unnamed: D48.1, SW53.1 (A)
unnamed: D48.2, SW49.1 (A)
unnamed: D48.5, SW45.1 (A)
unnamed: D49.1, SW54.1 (A)
unnamed: D49.2, SW50.1 (A)
unnamed: D49.5, SW46.1 (A)
