aynurin/nourik/(commit log)

2022-07-07 Initial schematics
    [NourK.kicad_pcb, NourK.kicad_sch, lhs.keys.kicad_sch, lhs.kicad_sch, lhs.leds.kicad_sch]
2022-07-09 Add RHS schematics sheets
    [NourK.kicad_sch, lhs.keys.kicad_sch, rhs.keys.kicad_sch, rhs.kicad_sch, rhs.leds.kicad_sch, stm32l082.setup.kicad_sch]
2022-07-15 Draft LHS tracks
    [NourK.kicad_pcb, NourK.kicad_sch, core.kicad_sch, lhs.keys.kicad_sch, lhs.kicad_sch, lhs.leds.kicad_sch, rhs.keys.kicad_sch, rhs.kicad_sch]
2022-07-15 Matrices connection traces
    [NourK.kicad_pcb]
2022-07-15 Initial tracing of the keyboard controller
    [NourK.kicad_pcb]
2022-08-13 Re-traced RHS
    [NourK.kicad_pcb, NourK.kicad_sch, core.kicad_sch, lhs.kicad_sch, lhs.leds.kicad_sch, rhs.keys.kicad_sch, rhs.kicad_sch, rhs.leds.kicad_sch]
2022-08-14 Initial RHS DRC checked
    [NourK.kicad_pcb, NourK.kicad_sch, core.kicad_sch]
2022-08-21 RHS and LHS wire complete and initial DRC
    [NourK.kicad_pcb, NourK.kicad_sch, core.kicad_sch, lhs.keys.kicad_sch, lhs.kicad_sch, lhs.leds.kicad_sch, rhs.keys.kicad_sch]
2022-08-21 Update schematics to match new footprints
    [NourK.kicad_pcb, NourK.kicad_sch, core.kicad_sch, rhs.leds.kicad_sch]
2022-08-21 Deal with DRC warnings due to silkscreen clipped by solder mask
    [NourK.kicad_pcb]
2022-08-29 Draft wire the core
    [NourK.kicad_pcb, NourK.kicad_sch, core.kicad_sch]
2022-09-04 Complete wiring
    [NourK.kicad_pcb, NourK.kicad_sch, core.kicad_sch, rhs.keys.kicad_sch]
2022-09-04 Add mounting holes
    [NourK.kicad_pcb]
2022-09-04 Add missing files
    [NourK-B_Cu.gbr, NourK-B_Mask.gbr, NourK-B_Paste.gbr, NourK-B_Silkscreen.gbr, NourK-Edge_Cuts.gbr, NourK-F_Cu.gbr, NourK-F_Mask.gbr, NourK-F_Paste.gbr]
2022-09-04 Rename project
    [Nour-Valkyrie.kicad_pcb, Nour-Valkyrie.kicad_sch, core.kicad_sch, lhs.keys.kicad_sch, lhs.kicad_sch, lhs.leds.kicad_sch, rhs.keys.kicad_sch, rhs.kicad_sch]
2022-09-04 Split the Core into a separate project
    [Nour-Core.kicad_pcb, Nour-Core.kicad_sch, Nour-Valkyrie.kicad_pcb, Nour-Valkyrie.kicad_sch, core.kicad_sch, lhs.keys.kicad_sch, lhs.kicad_sch, lhs.leds.kicad_sch]
2022-09-05 Removed unnecessary files
    [core.kicad_sch, lhs.keys.kicad_sch, lhs.kicad_sch, lhs.leds.kicad_sch, rhs.keys.kicad_sch, rhs.kicad_sch, rhs.leds.kicad_sch]
2022-09-10 v0.1 gerbers
    [Nour-Core-B_Cu.gbr, Nour-Core-B_Mask.gbr, Nour-Core-B_Paste.gbr, Nour-Core-B_Silkscreen.gbr, Nour-Core-Edge_Cuts.gbr, Nour-Core-F_Cu.gbr, Nour-Core-F_Mask.gbr, Nour-Core-F_Paste.gbr]
